vorwieger/modular-link/doc/schema.pdf

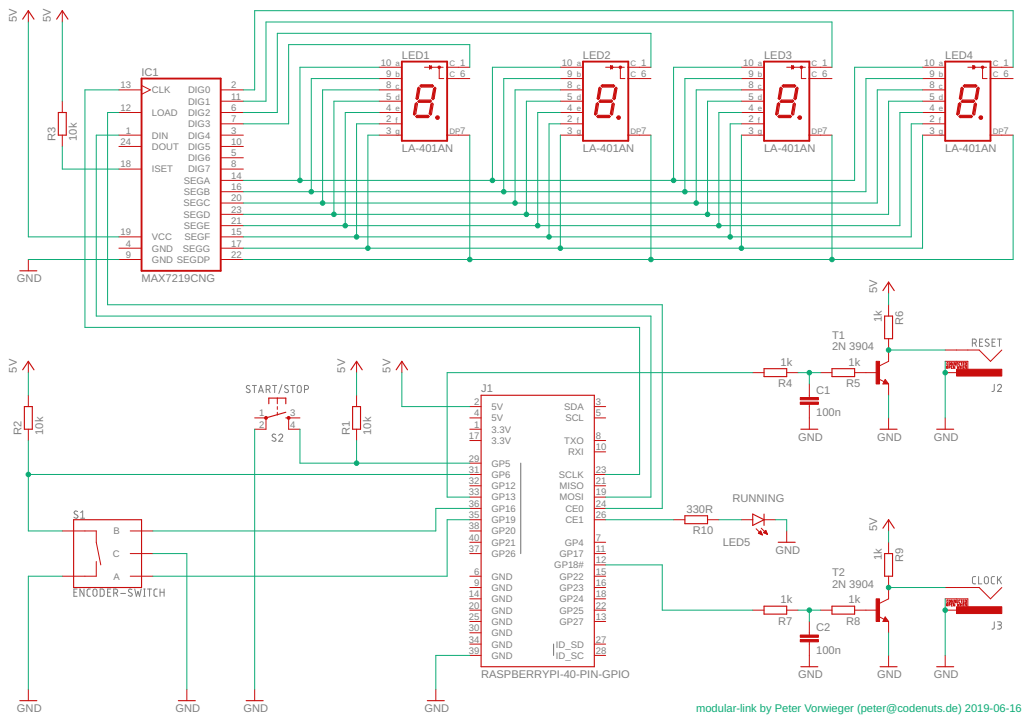
[picture p4: page 1]
