vorwieger/modular-link/doc/schema.sch

## EAGLE design doc/schema.sch (2019-06-16)

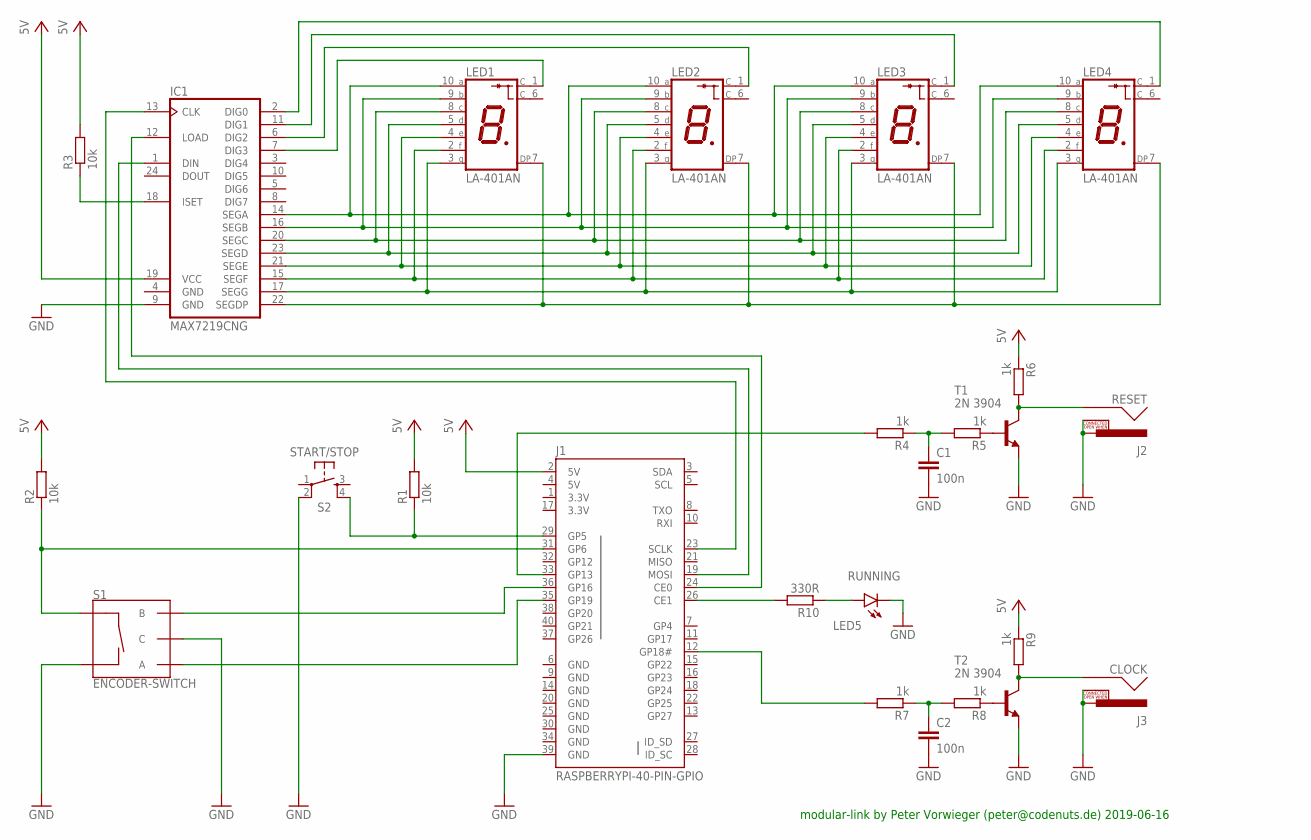
[picture p5: schematic schema.sch]

Parts:
C1, C2: 100n; C025-024X044
IC1: MAX7219CNG; DIL24-3
J1: RASPBERRYPI-40-PIN-GPIO; 2X20
J2: RESET; RCA
J3: CLOCK; RCA
LED1, LED2, LED3, LED4: LA-401AN; LA-401
LED5: RUNNING; MINI-TOPLED-SANTANA
R1, R2, R3: 10k; 0204/5
R4, R5, R6, R7, R8, R9: 1k; 0204/5
R10: 330R; 0204/5
S1: ENCODER-SWITCH; ROTARY_ENC_PLAIN
S2: START/STOP; TACTILE_SWITCH_SMD_5.2MM
T1, T2: 2N 3904; TO92-EBC

Connections:
GND: C1.2, C2.2, IC1.9 (GND), J1.39 (GND), J2.PIN, J2.SWITCH, J3.PIN, J3.SWITCH, LED5.C, S1.C, S1.SW-, S2.2, T1.E, T2.E
unnamed: J1.31 (GP6), R2.1, S1.SW+
unnamed: IC1.14 (SEGA), LED1.10 (A), LED2.10 (A), LED3.10 (A), LED4.10 (A)
unnamed: IC1.16 (SEGB), LED1.9 (B), LED2.9 (B), LED3.9 (B), LED4.9 (B)
unnamed: IC1.20 (SEGC), LED1.8 (C), LED2.8 (C), LED3.8 (C), LED4.8 (C)
unnamed: IC1.23 (SEGD), LED1.5 (D), LED2.5 (D), LED3.5 (D), LED4.5 (D)
unnamed: IC1.22 (SEGDP), LED1.7 (DP), LED2.7 (DP), LED3.7 (DP), LED4.7 (DP)
unnamed: IC1.7 (DIG3), LED1.1 (C)
unnamed: J1.35 (GP19), S1.A
unnamed: IC1.11 (DIG1), LED3.1 (C)
unnamed: IC1.2 (DIG0), LED4.1 (C)
unnamed: IC1.6 (DIG2), LED2.1 (C)
unnamed: J1.29 (GP5), R1.1, S2.4
unnamed: IC1.21 (SEGE), LED1.4 (E), LED2.4 (E), LED3.4 (E), LED4.4 (E)
unnamed: IC1.15 (SEGF), LED1.2 (F), LED2.2 (F), LED3.2 (F), LED4.2 (F)
unnamed: J1.36 (GP16), S1.B
unnamed: J1.26 (CE1), R10.2
unnamed: IC1.17 (SEGG), LED1.3 (G), LED2.3 (G), LED3.3 (G), LED4.3 (G)
unnamed: IC1.18 (ISET), R3.1
unnamed: IC1.1 (DIN), J1.19 (MOSI)
unnamed: IC1.12 (LOAD), J1.24 (CE0)
unnamed: IC1.13 (CLK), J1.23 (SCLK)
unnamed: J1.12 (GP18#), R7.2
unnamed: J1.33 (GP13), R4.2
unnamed: R5.1, T1.B
unnamed: J2.SHELL, R6.2, T1.C
unnamed: C1.1, R4.1, R5.2
unnamed: C2.1, R7.1, R8.2
unnamed: R8.1, T2.B
unnamed: J3.SHELL, R9.2, T2.C
unnamed: LED5.A, R10.1
VCC: IC1.19 (VCC), J1.2 (5V), R1.2, R2.2, R3.2, R6.1, R9.1

Notes on the sheet:
modular-link by Peter Vorwieger (peter@codenuts.de) 2019-06-16
