vorwieger/modular-link/(commit log)

2019-04-21 First cut
2019-04-28 Complete rewrite from CircuitHappy/HelloLink
2019-05-05 Unbounced Input-Buttons
2019-05-05 Encoder can change Tempo
2019-05-06 Short delay to make MAX7219 reliable
    [Max7219.cpp]
2019-05-07 BugFix Default Tempo 120
    [Output.cpp, Output.h, State.cpp, State.h]
2019-05-08 refactoring, but Bug in Display...
    [Display.cpp, Display.h, Input.cpp, Input.h, Max7219.cpp, Max7219.h, Output.cpp, Output.h]
2019-05-08 BugFix Display: Mutex ist dein Freund.
    [Max7219.cpp, Max7219.h, State.cpp]
2019-05-09 Bugfix: Length of Loop not correct implemented
    [State.cpp]
2019-05-09 Encoder Rotation Debounced
2019-06-16 Some documentation added
    [schema.sch]
2021-02-06 Encode and Start/Stop over Interrupt
